mithro/pmod-cp2104/pmod-cp2104.sch

## KiCad design pmod-cp2104.sch (2016-11-27)

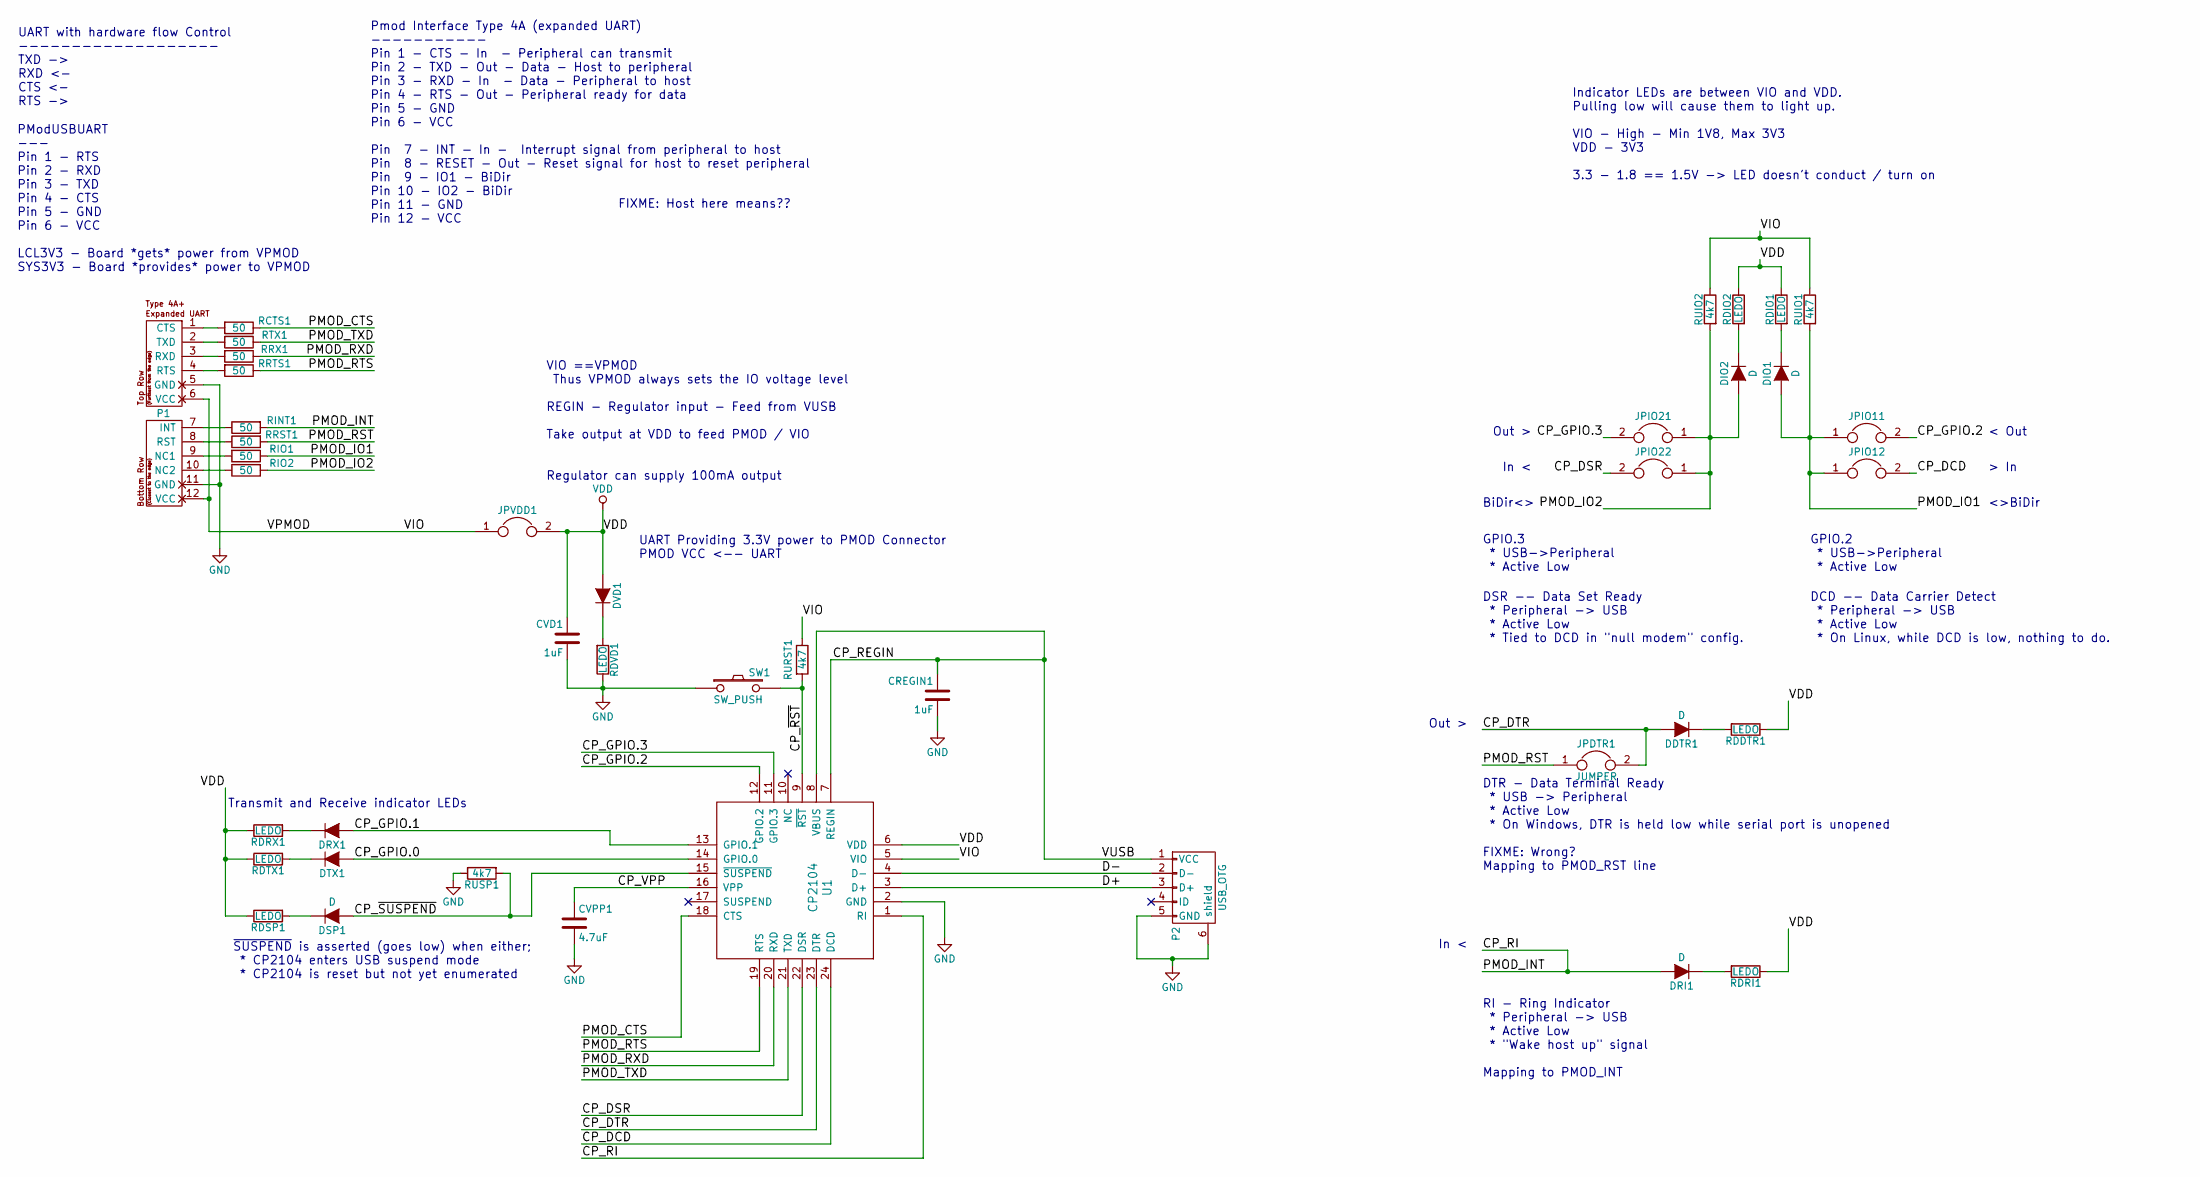
[picture p1: schematic pmod-cp2104.sch]

Parts:
CREGIN1: 1uF; C_0805
CVD1: 1uF; C_0805
CVPP1: 4.7uF; C_0805
DDTR1: D; LED_0402
DIO1, DIO2: D; LED_0402
DRI1: D; LED_0402
DRX1: D; LED_0402
DSP1: D; LED_0402
DTX1: D; LED_0402
DVD1: D; LED_0402
JPDTR1: JUMPER; Pin_Header_Straight_1x02
JPIO11, JPIO12, JPIO21, JPIO22: JUMPER; Pin_Header_Straight_1x02
JPVDD1: JUMPER; Pin_Header_Straight_1x02
P1: PMOD-Device-x2-Type-4A+-Expanded-UART; pmod_pin_array_6x2
P2: USB_OTG; USB_Mini-B
RCTS1: 50; R_0603
RDDTR1: LEDO; R_0603
RDIO1, RDIO2: LEDO; R_0603
RDRI1: LEDO; R_0603
RDRX1: LEDO; R_0603
RDSP1: LEDO; R_0603
RDTX1: LEDO; R_0603
RDVD1: LEDO; R_0603
RINT1: 50; R_0603
RIO1, RIO2: 50; R_0603
RRST1: 50; R_0603
RRTS1: 50; R_0603
RRX1: 50; R_0603
RTX1: 50; R_0603
RUIO1, RUIO2: 4k7; R_0603
RURST1: 4k7; R_0603
RUSP1: 4k7; R_0603
SW1: SW_PUSH; SW_SPST_PTS645
U1: CP2104; QFN-24_4x4mm_Pitch0.5mm

Connections:
CP_DCD: JPIO12.2, U1.24 (DCD)
CP_DSR: JPIO22.2, U1.22 (DSR)
CP_DTR: DDTR1.2 (A), JPDTR1.2, U1.23 (DTR)
CP_GPIO.0: DTX1.2 (A), U1.14 (GPIO.0)
CP_GPIO.1: DRX1.2 (A), U1.13 (GPIO.1)
CP_GPIO.2: JPIO11.2, U1.12 (GPIO.2)
CP_GPIO.3: JPIO21.2, U1.11 (GPIO.3)
CP_REGIN: CREGIN1.1, P2.1 (VCC), U1.7 (REGIN), U1.8 (VBUS)
CP_RI: DRI1.2 (A), RINT1.2, U1.1 (RI)
CP_VPP: CVPP1.1, U1.16 (VPP)
CP_~RST: RURST1.2, SW1.2, U1.9 (~RST)
CP_~SUSPEND~: DSP1.2 (A), RUSP1.2, U1.15 (~SUSPEND)
D+: P2.3 (D+), U1.3 (D+)
D-: P2.2 (D-), U1.4 (D-)
GND: CREGIN1.2, CVD1.2, CVPP1.2, P1.5 (GND), P1.11 (GND), P2.5 (GND), P2.6 (shield), RDVD1.1, RUSP1.1, SW1.1, U1.2 (GND)
unnamed: DDTR1.1 (K), RDDTR1.2
unnamed: DIO1.1 (K), RDIO1.2
unnamed: DIO2.1 (K), RDIO2.2
unnamed: DRI1.1 (K), RDRI1.2
unnamed: DRX1.1 (K), RDRX1.2
unnamed: DSP1.1 (K), RDSP1.2
unnamed: DTX1.1 (K), RDTX1.2
unnamed: DVD1.1 (K), RDVD1.2
unnamed: P1.1 (CTS), RCTS1.2
unnamed: P1.2 (TXD), RTX1.2
unnamed: P1.3 (RXD), RRX1.2
unnamed: P1.4 (RTS), RRTS1.2
unnamed: P1.7 (INT), RINT1.1
unnamed: P1.8 (RST), RRST1.1
unnamed: P1.9 (NC1), RIO1.2
unnamed: P1.10 (NC2), RIO2.1
PMOD_CTS: RCTS1.1, U1.18 (CTS)
PMOD_IO1: DIO1.2 (A), JPIO11.1, JPIO12.1, RIO1.1, RUIO1.2
PMOD_IO2: DIO2.2 (A), JPIO21.1, JPIO22.1, RIO2.2, RUIO2.2
PMOD_RST: JPDTR1.1, RRST1.2
PMOD_RTS: RRTS1.1, U1.19 (RTS)
PMOD_RXD: RRX1.1, U1.20 (RXD)
PMOD_TXD: RTX1.1, U1.21 (TXD)
VDD: CVD1.1, DVD1.2 (A), JPVDD1.2, RDDTR1.1, RDIO1.1, RDIO2.1, RDRI1.1, RDRX1.1, RDSP1.1, RDTX1.1, U1.6 (VDD)
VIO: JPVDD1.1, P1.6 (VCC), P1.12 (VCC), RUIO1.1, RUIO2.1, RURST1.1, U1.5 (VIO)

Notes on the sheet:
UART with hardware flow Control ------------------- TXD -> RXD <- CTS <- RTS ->
Pmod Interface Type 4A (expanded UART) ----------- Pin 1 - CTS - In - Peripheral can transmit Pin 2 - TXD - Out - Data - Host to peripheral Pin 3 - RXD - In - Data - Peripheral to host Pin 4 - RTS - Out - Peripheral ready for data Pin 5 - GND Pin 6 - VCC Pin 7 - INT - In - Interrupt signal from per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
PModUSBUART --- Pin 1 - RTS Pin 2 - RXD Pin 3 - TXD Pin 4 - CTS Pin 5 - GND Pin 6 - VCC LCL3V3 - Board *gets* power from VPMOD SYS3V3 - Board *provides* power to VPMOD
VIO ==VPMOD Thus VPMOD always sets the IO voltage level REGIN - Regulator input - Feed from VUSB Take output at VDD to feed PMOD / VIO Regulator can supply 100mA output
RI - Ring Indicator * Peripheral -> USB * Active Low * "Wake host up" signal Mapping to PMOD_INT
DTR - Data Terminal Ready * USB -> Peripheral * Active Low * On Windows, DTR is held low while serial port is unopened FIXME: Wrong? Mapping to PMOD_RST line
DCD -- Data Carrier Detect * Peripheral -> USB * Active Low * On Linux, while DCD is low, nothing to do.
DSR -- Data Set Ready * Peripheral -> USB * Active Low * Tied to DCD in "null modem" config.
GPIO.3 * USB->Peripheral * Active Low
GPIO.2 * USB->Peripheral * Active Low
< Out
> In
<>BiDir
Out >
In <
BiDir<>
~SUSPEND~ is asserted (goes low) when either; * CP2104 enters USB suspend mode * CP2104 is reset but not yet enumerated
Transmit and Receive indicator LEDs
UART Providing 3.3V power to PMOD Connector PMOD VCC <-- UART
Indicator LEDs are between VIO and VDD. Pulling low will cause them to light up. VIO - High - Min 1V8, Max 3V3 VDD - 3V3 3.3 - 1.8 == 1.5V -> LED doesn't conduct / turn on
FIXME: Host here means??
