mithro/pmod-cp2104/(threads)

Thread 5 (2016-10-05):

Figure out LED colors

mithro, 2016-10-05:
Power LED - Color 0

TX - Color 1
RX - Color 2

RST - Color 3
INT - Color 4

IO1 / IO2 - Color 5

mithro, 2016-10-05:
* http://www.digikey.com/short/39h70v

LED colors seem to be Red, Yellow, Green, White for VCC 1.8V
