mithro/pmod-cp2104/(commit log)

2016-10-05 Initial working out of the schematic.
    [pmod-cp2104.kicad_pcb, pmod-cp2104.sch]
2016-10-05 Move the protection resistors to around the pmod header.
    [pmod-cp2104.sch]
2016-10-05 Remove some unused wires.
    [pmod-cp2104.sch]
2016-10-05 Rearranging things a little.
    [pmod-cp2104.sch]
2016-10-05 Make the LEDs be between VIO and VDD.
    * High - LED is off
    * Low - LED is on
    [pmod-cp2104.sch]
2016-10-05 Change LED resistor to be value "LEDO"
    [pmod-cp2104.sch]
2016-10-06 Slowly starting to connect everything together.
    [pmod-cp2104.sch]
2016-10-06 Adding footprints for everything.
    [pmod-cp2104.sch]
2016-10-06 Fixing for parts I already have.
    [pmod-cp2104.sch]
2016-10-06 Lots of small changes.
    [pmod-cp2104.sch]
2016-11-27 Making everything fit on one sheet.
    [pmod-cp2104.sch]
2016-11-27 Changing to using the pmod library.
    [pmod-cp2104.kicad_pcb, pmod-cp2104.sch]
2016-12-01 First version of PCB routing.
    [pmod-cp2104.kicad_pcb]
2016-12-02 Second version from Phyllis.
    [pmod-cp2104.kicad_pcb]
2016-12-14 Update from Phyllis.
    [pmod-cp2104.kicad_pcb]
